azerimaker/olmBoard-RP605x/hardware/olmBoard-RP605x-v1/bom/olmBoard-RP605x-v1.xlsx

Item | Qty | Reference(s) | Value | Footprint | Datasheet | DNP | LCSC | MPN
1 | 3 | C1, C6, C7 | 22uF | Capacitor_SMD:C_0805_2012Metric | ~ |  | C45783 | CL21A226MAQNNNE
2 | 3 | C2, C3, C4 | 100nF | Capacitor_SMD:C_0603_1608Metric | ~ |  | C14663 | CC0603KRX7R9BB104
3 | 1 | C5 | 1uF | Capacitor_SMD:C_0805_2012Metric | ~ |  | C28323 | CL21B105KBFNNNE
5 | 2 | J1, J2 | VIN, VOUT | Connector_JST:JST_PH_S2B-PH-SM4-TB_1x02-1MP_P2.00mm_Horizontal | ~ |  | C295747 | S2B-PH-SM4-TB(LF)(SN)
7 | 2 | J3, J4 | Conn_A_B | Connector_PinHeader_2.54mm:PinHeader_1x04_P2.54mm_Vertical | ~ |  | - | -
10 | 1 | L1 | 2.2uH | Inductor_SMD:L_1008_2520Metric |  |  | C1330943 | MLP2520S2R2ST0S1
11 | 1 | R1 | 100K | Resistor_SMD:R_0603_1608Metric | ~ |  | C25803 | 0603WAF1003T5E
12 | 1 | U1 | RP605K333B | node-lib:DFN-12-1EP_2.7x3mm_P0.5mm_EP1.7x2.7mm |  |  |  | RP605K333B
