azerimaker/olmBoard-RP605x/hardware/olmBoard-RP605x-v1/olmBoard-RP605x-v1-Sch.pdf

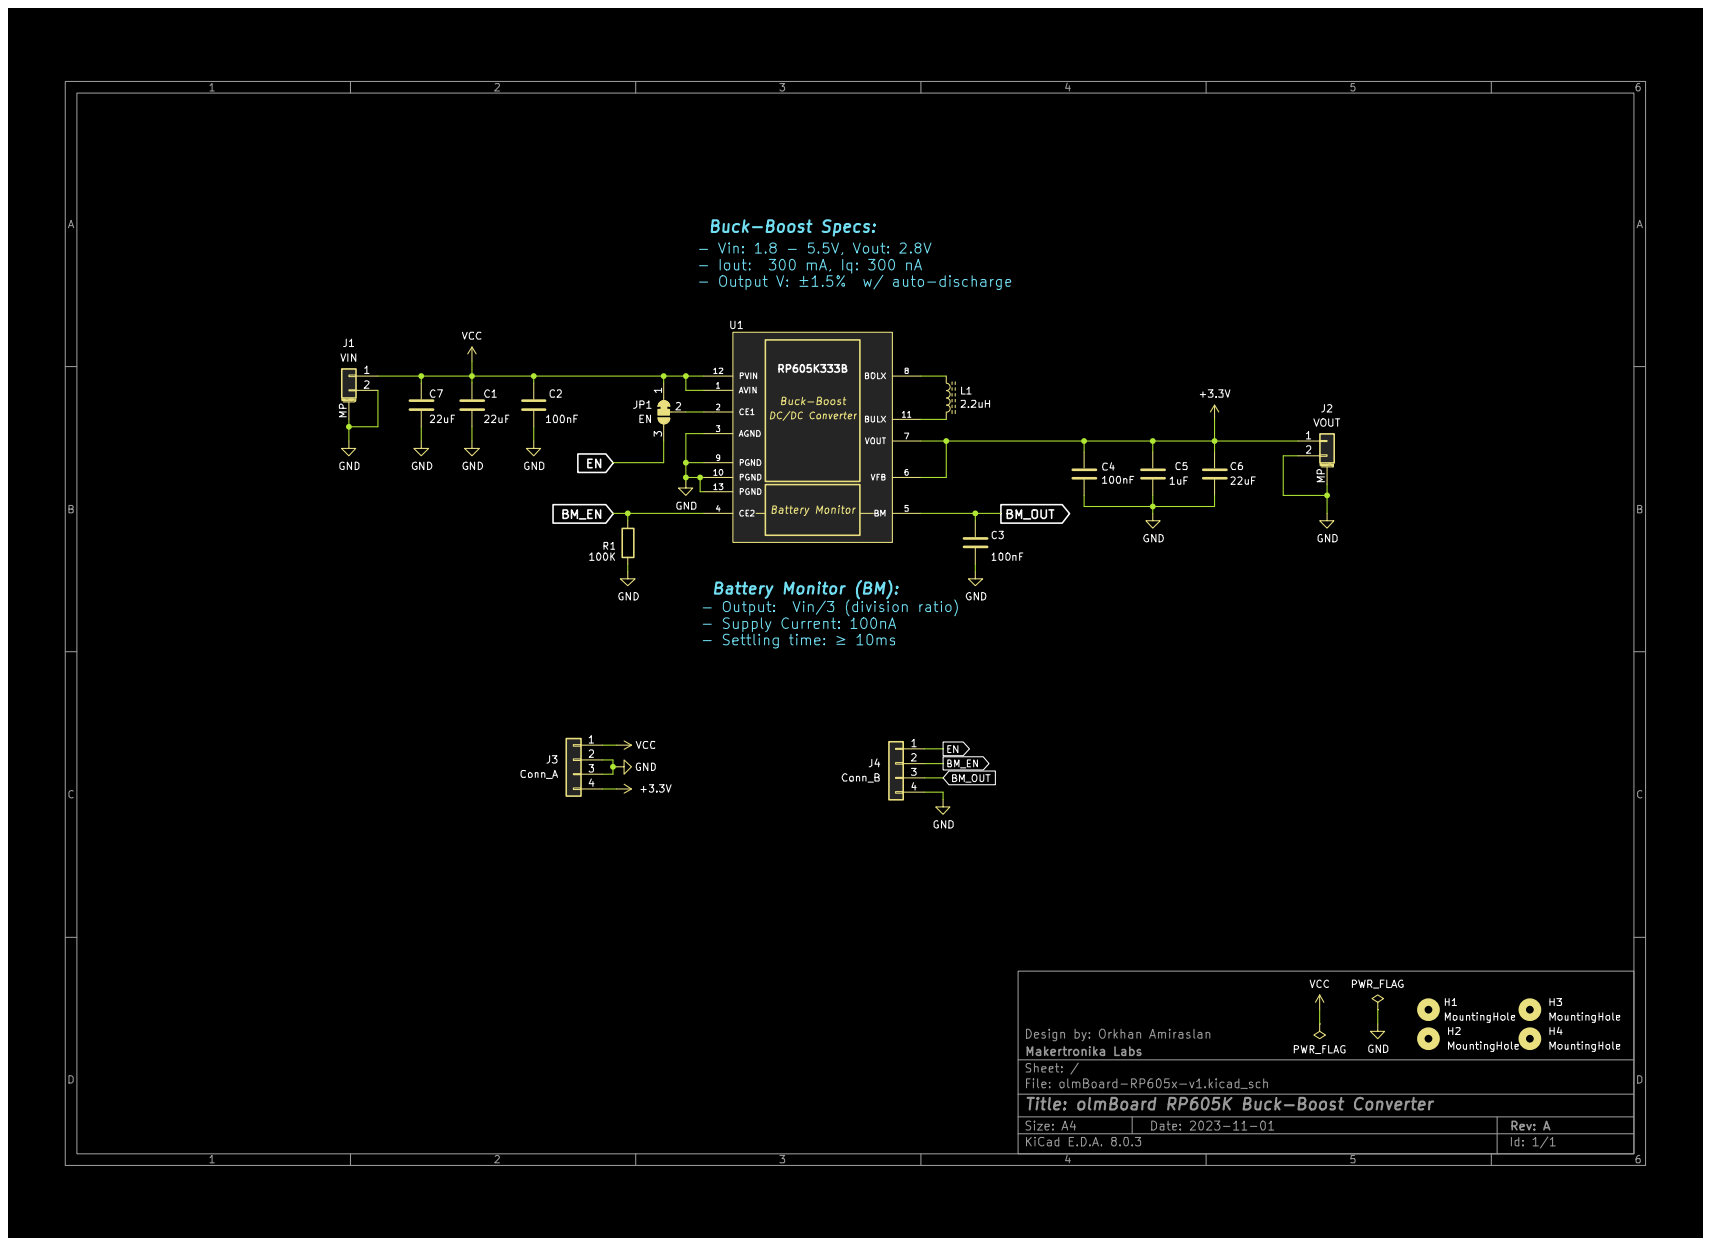
[picture p2: page 1]
