azerimaker/olmBoard-RP605x/hardware/olmBoard-RP605x-v1/olmBoard-RP605x-v1.kicad_pcb

## KiCad design hardware/olmBoard-RP605x-v1/olmBoard-RP605x-v1.kicad_pcb (2024-07-17)

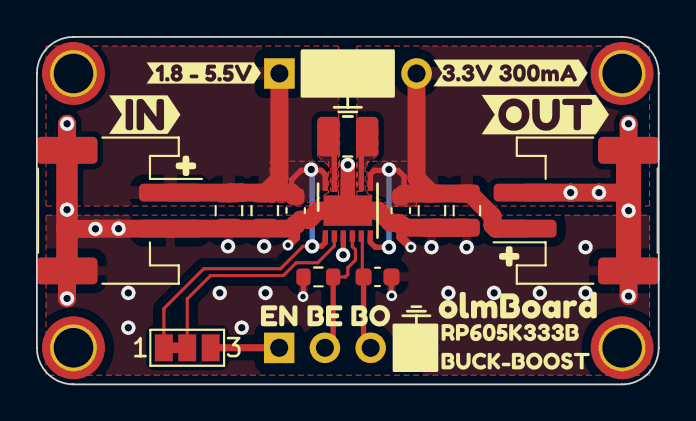
[picture p3: board olmBoard-RP605x-v1.kicad_pcb from above]

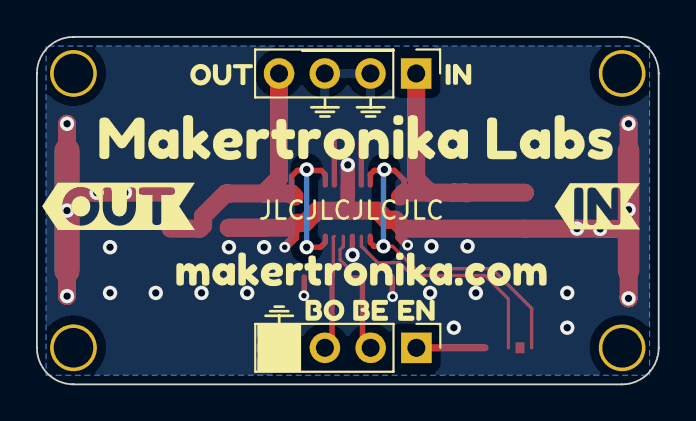
[picture p4: board olmBoard-RP605x-v1.kicad_pcb from below]

Board: 2 copper layers, 34.5 x 19.3 mm, 40 parts (11 on the bottom side), 9 nets.

Parts:
C1, C6, C7: 22uF; C_0805_2012Metric
C2, C3, C4: 100nF; C_0603_1608Metric
C5: 1uF; C_0805_2012Metric
G-logo: LOGO; makertronika-sm-8mm
H1, H2, H3, H4: MountingHole; MountingHole_2.2mm_M2_ISO7380_Pad_TopOnly
J1, J2: VIN; JST_PH_S2B-PH-SM4-TB_1x02-1MP_P2.00mm_Horizontal
J3: Conn_A; PinHeader_1x04_P2.54mm_Vertical
J4: Conn_B; PinHeader_1x04_P2.54mm_Vertical
JP1: EN; SolderJumper-3_P1.3mm_Bridged12_Pad1.0x1.5mm_NumberLabels
L1: 2.2uH; L_1008_2520Metric
R1: 100K; R_0603_1608Metric
U1: RP605K333B; DFN-12-1EP_2.7x3mm_P0.5mm_EP1.7x2.7mm
kibuzzard-658B4DF6: G***; kibuzzard-658B4DF6
kibuzzard-658B4DFC: G***; kibuzzard-658B4DFC
kibuzzard-658B4E8C: G***; kibuzzard-658B4E8C
kibuzzard-658B4E9D: G***; kibuzzard-658B4E9D
kibuzzard-65424F22, kibuzzard-65424F22#2: G***; kibuzzard-65424F22
kibuzzard-654250E5: G***; kibuzzard-654250E5
kibuzzard-654250EC: G***; kibuzzard-654250EC
kibuzzard-654258D9, kibuzzard-654258D9#2: G***; kibuzzard-654258D9
kibuzzard-654268F6: G***; kibuzzard-654268F6
kibuzzard-6542501C, kibuzzard-6542501C#2: G***; kibuzzard-6542501C
kibuzzard-6542684A: G***; kibuzzard-6542684A
kibuzzard-65425023, kibuzzard-65425023#2: G***; kibuzzard-65425023
kibuzzard-65426016: G***; kibuzzard-65426016
kibuzzard-65426020: G***; kibuzzard-65426020
kibuzzard-65426266: G***; kibuzzard-65426266
kibuzzard-65426283: G***; kibuzzard-65426283

Connections:
+3.3V: C4.2, C5.1, C6.2, J2.1, J3.4, U1.6 (VFB), U1.7 (VOUT)
BM_EN: J4.2, R1.2, U1.4 (CE2)
BM_OUT: C3.1, J4.3, U1.5 (BM)
EN: J4.1, JP1.3 (B)
GND: C1.1, C2.2, C3.2, C4.1, C5.2, C6.1, C7.1, J1.2, J1.MP (MountPin), J2.2, J2.MP (MountPin), J3.2, J3.3, J4.4, R1.1, U1.3 (AGND), U1.9 (PGND), U1.10 (PGND), U1.13 (PGND)
unnamed: JP1.2 (C), U1.2 (CE1)
unnamed: L1.1, U1.8 (BOLX)
unnamed: L1.2, U1.11 (BULX)
VCC: C1.2, C2.1, C7.2, J1.1, J3.1, JP1.1 (A), U1.1 (AVIN), U1.12 (PVIN)
